IKKUengine/MYiTOPS/teams/Team Malaysia 2019/readme.txt

This is a clone of our folders for mechanical design, software design and organization.
Updated on: 8.5.19
