IKKUengine/MYiTOPS/teams/Team Malaysia 2019/Proposal/MindMap.pptx

from Car (CAN)

external

Dyno

Motor Control

Actuator

Speed

position sensor

Stepper

Sensor

failsafe

mech. failsafe

Remote Actuator

Labview

Software

Controller

Speed Controller PID (limits!)

Remote Controle

Raspberry Pie

phone

computer
