IKKUengine/MYiTOPS/teams/Team Malaysia 2019/Software/GUI.docx

send:

speed

- +/- arrow
- create profile with datapoints and time
- load .csv file

(angle of throttle)

emergency button

recieve:

current speed of car

throttle position from pid controller loop
