IKKUengine/MYiTOPS/teams/Team Malaysia 2019/Presentations/Sternfeuerung 1_0_Skype Meeting.pptx

## Sternfeuerung 1.0

## How does it work? Part 1

#include: Tkinter

→ for graphic user interface (gui)

#include: PyLSL

→ Lab streaming layer
- transfer data in a LAN
- Fastest possible latency

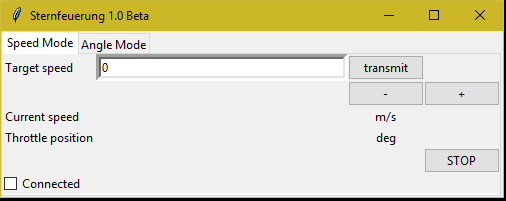
[picture p16: figure]
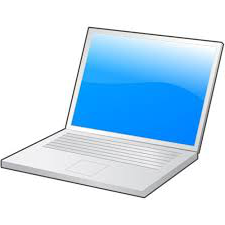
[picture p17: figure]
Bildergebnis fÃ¼r laptop zeichnung

User data

## How does it work? Part 2

Hamachi Server simulates a local area network (LAN)

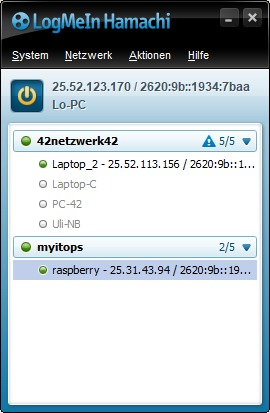
[picture p18: figure]
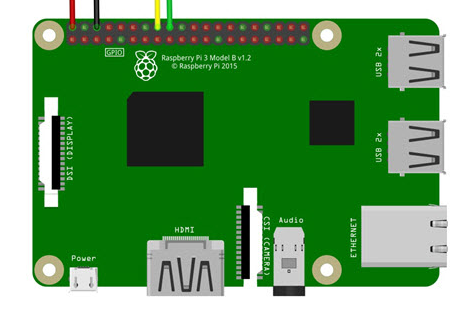
[picture p19: figure]
Bildergebnis fÃ¼r microcontroller raspberry schema

## How does it work? Part 3

#include: PiGPIO

→ Stable servo motor signal
→ CPU load independent

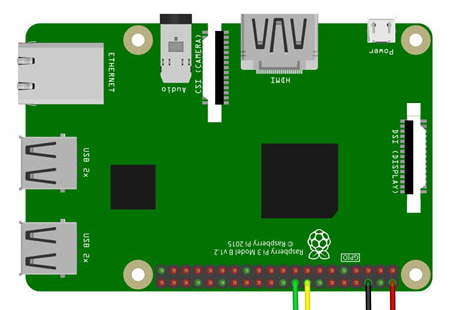
[picture p20: figure]
Bildergebnis fÃ¼r microcontroller raspberry schema

Actual Vehicle Speed

Actuator

## How does it work? Part 4

Actual Vehicle Speed

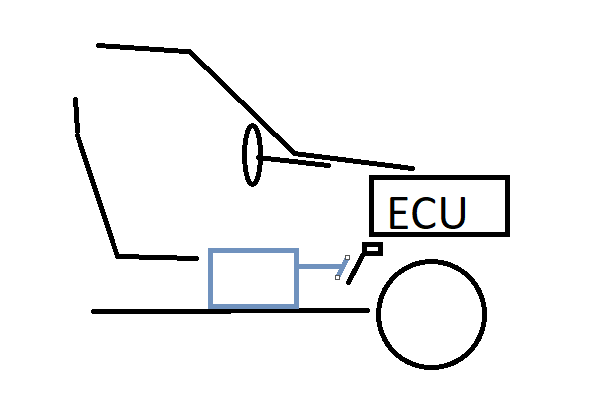
[picture p21: figure]

Throttle position

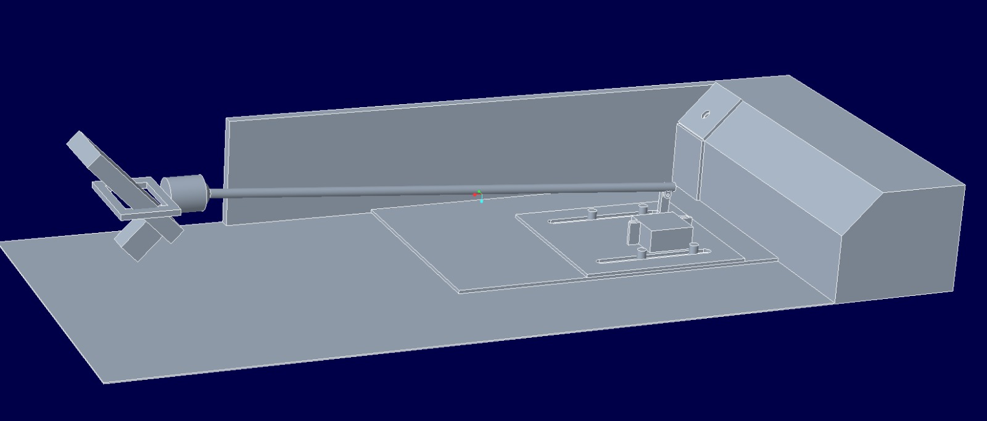
[picture p22: figure]

Actuator

## Slide 6

## How does it work? All in one

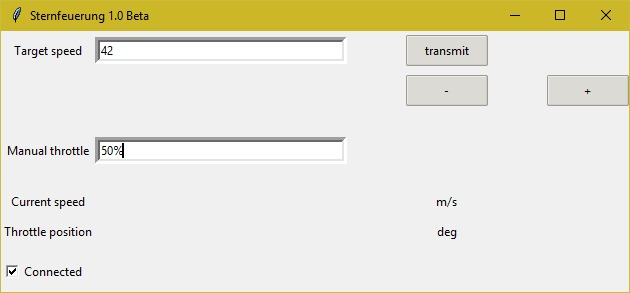
[picture p23: figure]

User data
