IKKUengine/MYiTOPS/teams/Team Malaysia 2019/Proposal/Actuator comparison.xlsx

article | Servo Motor | Linear Actuator
picture
Link | https://shopee.com.my/JX-CLS6336HV-Digital-Metal-Gear-Coreless-Motor-Servo-35.6kg-Torque-Aluminum-fyfb-i.111564047.1921093403 | https://www.lazada.com.my/products/12v-200n-100150200300mm-linear-actuator-motor-stroke-electric-door-opener-i441685108-s652625813.html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
easy assembly | easy attach of a lever servo motor is constantly poweering to hold the torque | direct mounting to throttle need of a displacement measurement
price | RM120.05 | RM103.23
displacement /angle per time | 545°/s | 30mm/s
force/torque | 35,6kNm | 200N
controle | Controllable angle range from 0 to 180 degrees given by a PWM signal | 0V to 12V to drive forward 0V to -12V to drive reverse no feedback about position
