IKKUengine/MYiTOPS/teams/Team Malaysia 2019/Proposal/team organization.docx

Project Manager
(Uli )
Mechanical Engineer
(Azril)
Software Engineer
(Lorenz)
Software Engineer
(Syakir)
Electrical Engineer
(Nurain)
Electrical Engineer
(Jakob)

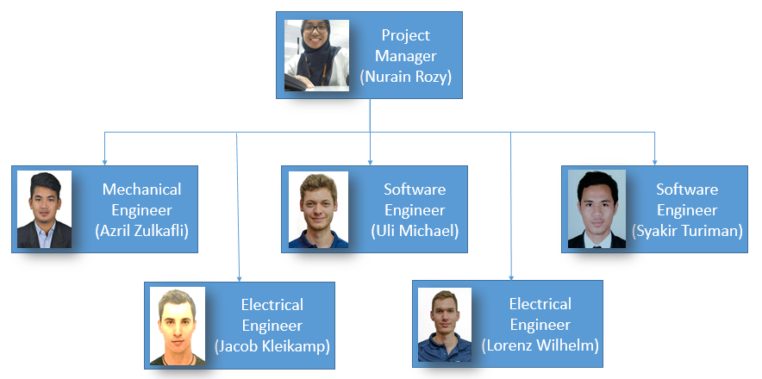
[picture p45: figure]
