IKKUengine/MYiTOPS/teams/Team Malaysia 2019/Proposal/team organization.pptx

Project Manager
(Nurain Rozy)

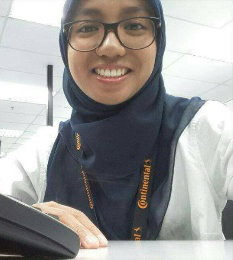
[picture p46: figure]

Mechanical
Engineer
(Azril Zulkafli)

Software Engineer
(Uli Michael)

Software Engineer
(Syakir Turiman)

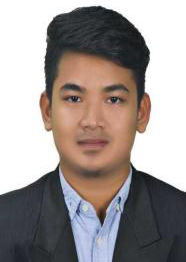
[picture p47: figure]
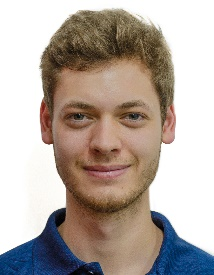
[picture p48: figure]
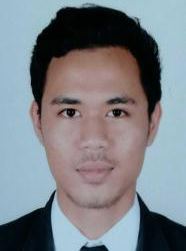
[picture p49: figure]

Electrical Engineer
(Jacob Kleikamp)

Electrical Engineer
(Lorenz Wilhelm)

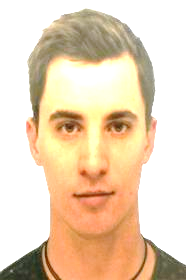
[picture p50: figure]
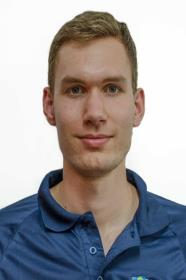
[picture p51: figure]
