IKKUengine/MYiTOPS/procurement workshop/2020/Rechnung_Masken.pdf

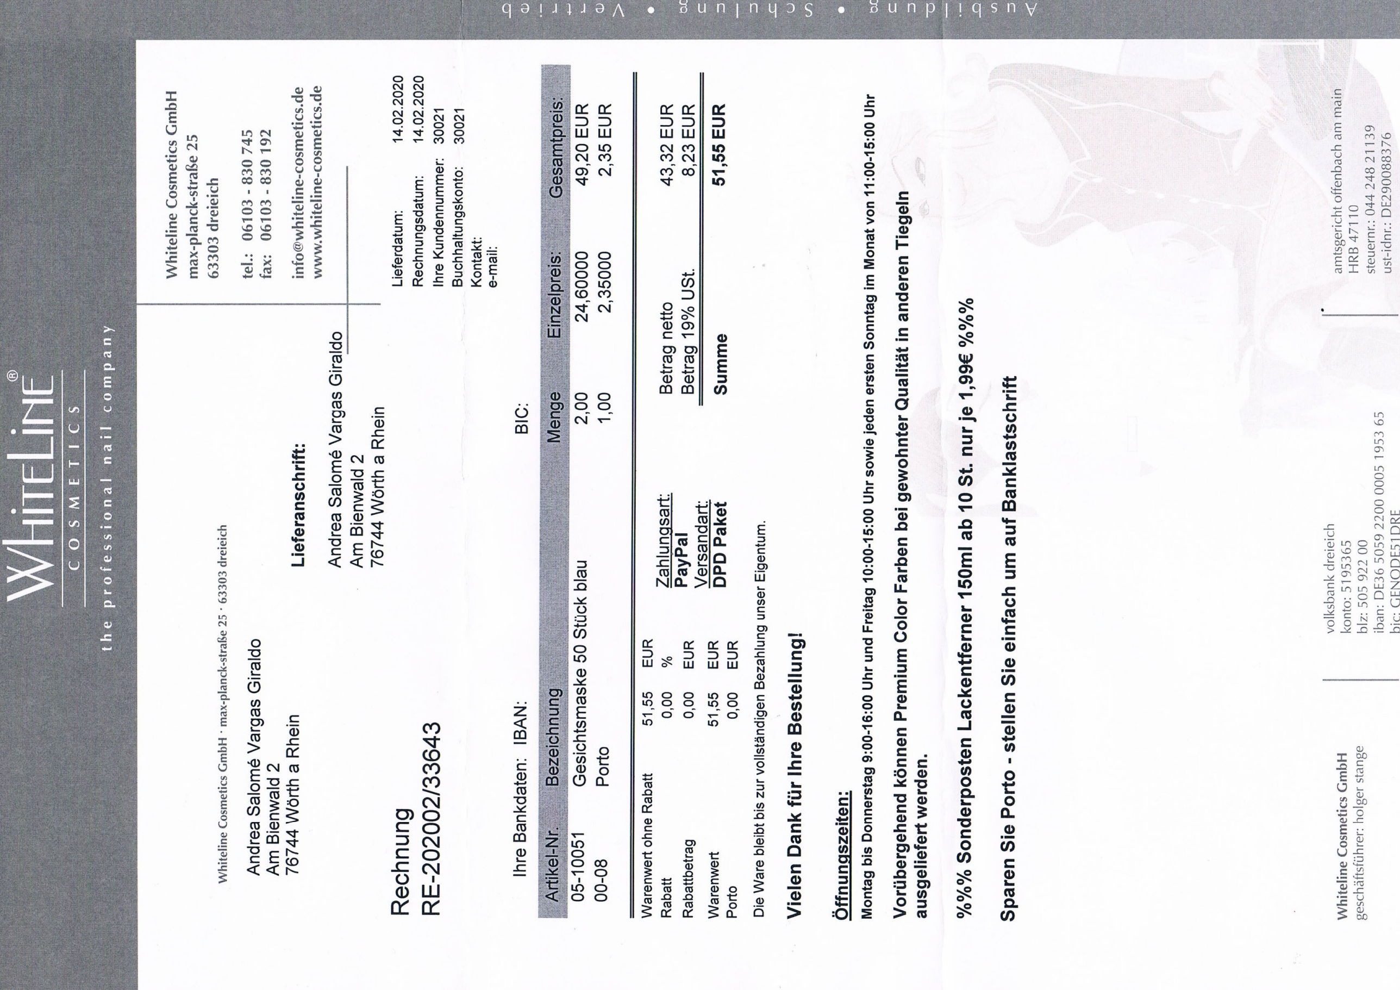
[picture p52: page 1]
