IKKUengine/MYiTOPS/teams/Team Malaysia 2019/Software/pingtest_from_germany.png

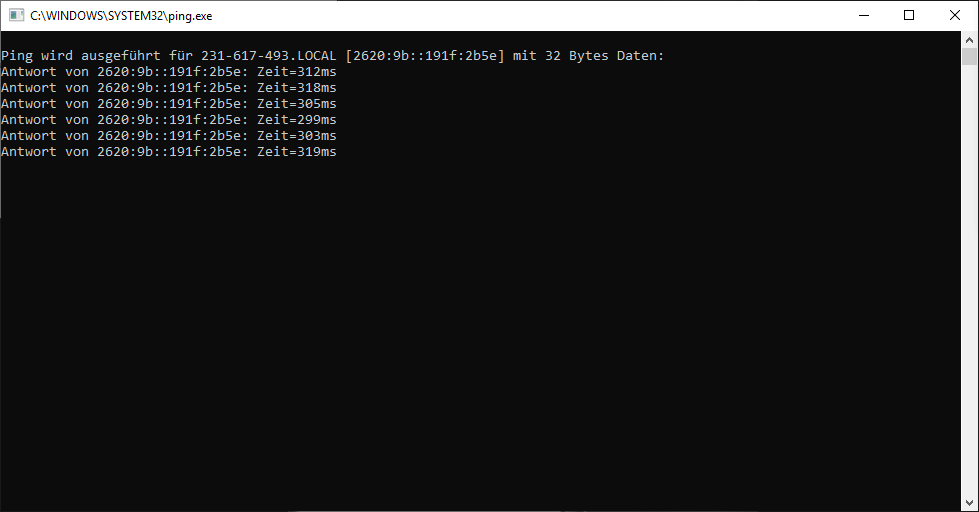
teams/Team Malaysia 2019/Software/pingtest_from_germany.png
