IKKUengine/MYiTOPS/teams/Team Malaysia 2020/Chainsaw/Order List_MYiTOPS V2.xlsx

No | Team | Komponente | Abmessungen (HxBxT) | Hersteller | Stückzahl | Kaufteil [ja/nein] | Shop | Bestellnummer | Kosten (netto)/ Stk | Kosten gesamt (netto) | Kosten gesamt (brutto) | Bemerkung | Link
1 | Group 1 | Battery Management System | Chip | CN | 1 | ja | Banggod.com |  | 2.00 € | 2.00 € | 2.00 € | Bestellt von Johannes K | https://de.banggood.com/3_7V7_4V-11_1V14_8V-Li-po-Battery-Indicator-Display-Board-Power-Storage-Monitor-p-1096280.html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
2 | Group 2 | Step-Down Spannungsregler LM 2596 | Chip | Geekcreit | 1 | ja | Banggod.com |  | 3.24 € | 3.24 € | 5.00 € | Bestellt von Johannes K | https://www.banggood.com/de/LM2596-DC-DC-Voltage-Regulator-Adjustable-Step-Down-Power-Supply-Module-With-Display-p-1005123.html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
3 | Group 2 | Kabelverschraubungen | - | Wiska | 10 | ja | Conrad.de |  | 0.47 € | 5 € | 5.00 € |  | https://www.conrad.de/de/p/kabelverschraubung-verschraubbar-mit-gegenmutter-pg9-pg9-polyamid-grau-1-1521119.html
4 | Group 2 | Zylinderschrauben 20 mm | M3 | Toolcraft | 2 | ja | Conrad.de |  | 2.49 € | 5 € | 5.00 € |  | https://www.conrad.de/de/p/toolcraft-830289-zylinderschrauben-m3-20-mm-innensechskant-din-912-kunststoff-polyamid-10-830289.html
5 | Group 2 | Nutensteine für 10 mm Nuten | M8 | Stritzelsberger | 2 | ja | Vakuumtisch.de |  | 14.99 € | 30 € | 30 € |  | https://www.vakuumtisch.de/Gussaluminium-T-Nutensteine-mit-M8-Gewinde-fuer-10mm-Nuten-10er-Pack
6 | Group 2 | Rundstecker | 3-Polig | TRUcomponents | 3 | ja | Conrad.de |  | 8.57 € | 25.71 € | 30.00 € |  | https://www.conrad.de/de/p/tru-components-1572445-rundstecker-konfektioniert-stecker-gerade-buchse-gerade-gesamtpolzahl-3-1-1572445.html
7 | Group 3 | Step-Down Spannungsregler LM 317 | Chip | QITA | 1 | ja | Conrad.de |  | 4.42 € | 5.00 € | 5.00 € |  | https://www.conrad.de/de/p/lm317-dc-dc-einstellbarer-step-down-spannungsregler-adjustable-konverter-802244045.html
8 | Group 3 | GPRS GSM Breakout-Modul | Chip | ARCELI | 1 | ja | Amazon.de |  | 7.99 € | 8.00 € | 8.00 € | Bestellt von Johannes K | https://www.amazon.de/ARCELI-Kleinster-Breakout-Modul-Quad-Band-SIM-Kartensteckplatz/dp/B07RHLP45T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
9 | Group 2 | Sechskantmuttern M3 | M3 | Toolcraft | 2 | ja | Conrad.de |  | 1.49 € | 2.98 € | 3.00 € |  | https://www.conrad.de/de/p/toolcraft-815969-sechskantmuttern-m3-kunststoff-10-815969.html
 |  |  |  |  |  |  |  |  |  | Gesamt | 93.00 €
