IKKUengine/MYiTOPS/teams/Team Malaysia 2019/Proposal/selection of criteria.xlsx

Sheet: Ranking
actuator to push the trottle | easy assembly | price | displacement/angle per time | force/torque | control | number of + signs | weighting
 |  |  |  |  |  | "+" | gK
easy assembly |  | + | - | - | - | 1 | 0.12
price | - |  | - | - | - | 0 | 0.00
displacement/angle per time | + | + |  | o | - | 2 | 0.25
force/torque | + | + | o |  | o | 2 | 0.25
control | + | + | + | o |  | 3 | 0.38
 |  |  |  |  |  | 8 | 1.00

Sheet: Hintergrundverknüpfungen
Quelle dropdown Ranking | +
 | -
 | o
 | ?
