IKKUengine/MYiTOPS/teams/Team Malaysia 2019/Actuator mechanical design/updated actuator.STEP

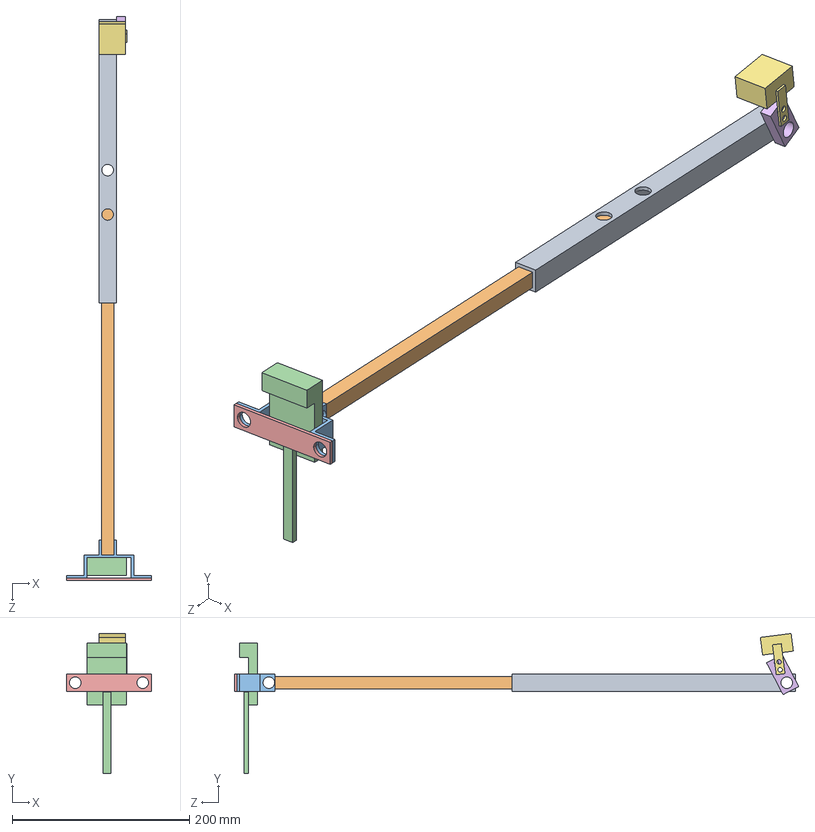
[picture p58: CAD file, 2020-02-21]
teams/Team Malaysia 2019/Actuator mechanical design/updated actuator.STEP
96.0 x 157.8 x 636.3 mm
