IKKUengine/MYiTOPS/teams/Team Malaysia 2019/Actuator mechanical design/actuator.edited.STEP

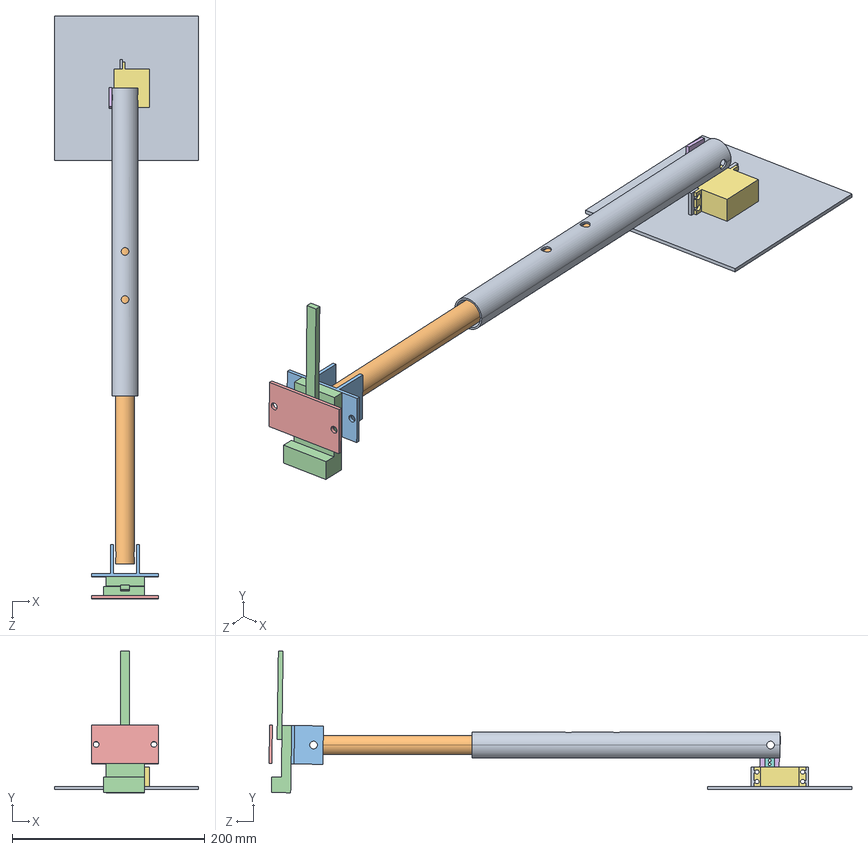
[picture p59: CAD file, 2020-02-21]
teams/Team Malaysia 2019/Actuator mechanical design/actuator.edited.STEP
150.0 x 147.1 x 605.7 mm
Big rod
Small rod
Pedal clamp
Gas pedal
Rear clamp
Lever
servo_rotational
servo arm
