IKKUengine/MYiTOPS/teams/Team Malaysia 2019/Actuator mechanical design/drawing actuator.STEP

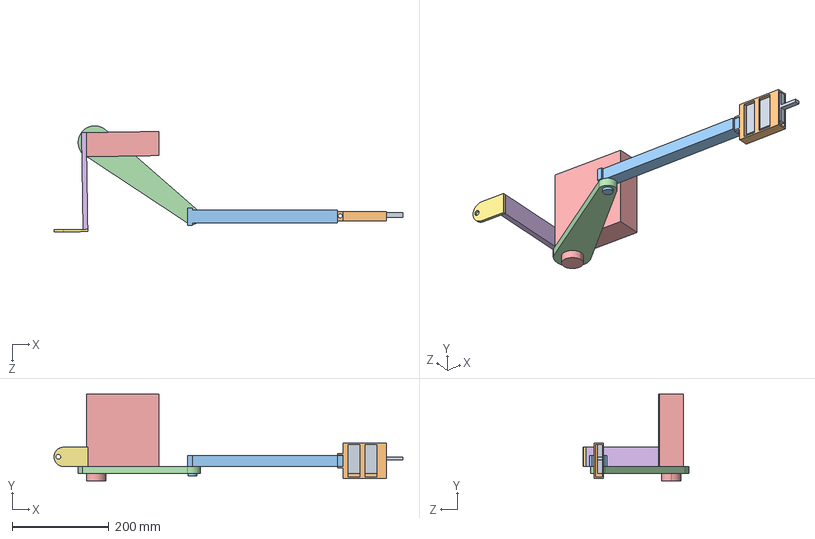
[picture p60: CAD file, 2020-02-21]
teams/Team Malaysia 2019/Actuator mechanical design/drawing actuator.STEP
722.3 x 180.0 x 220.1 mm
