IKKUengine/MYiTOPS/teams/Team Malaysia 2019/Actuator mechanical design/servo_rotational.stp

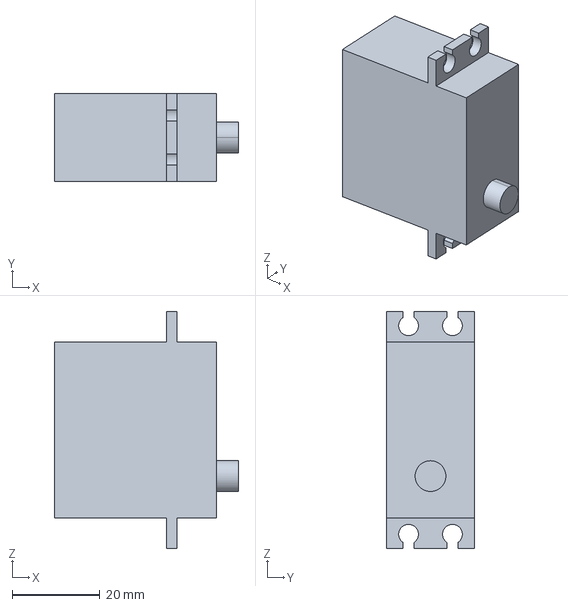
[picture p61: CAD file, 2020-02-21]
teams/Team Malaysia 2019/Actuator mechanical design/servo_rotational.stp
42.0 x 20.0 x 54.0 mm
