IKKUengine/MYiTOPS/teams/Team Malaysia 2019/Actuator mechanical design/M8_Metric_Nut.stp

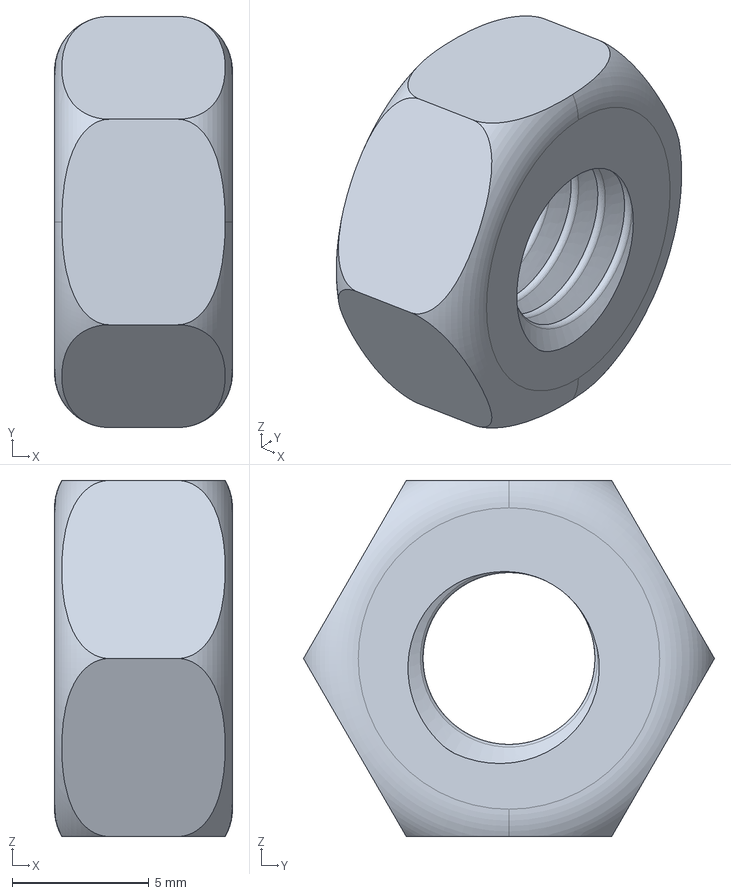
[picture p62: CAD file, 2020-02-21]
teams/Team Malaysia 2019/Actuator mechanical design/M8_Metric_Nut.stp
6.50 x 15.0 x 13.0 mm
