IKKUengine/MYiTOPS/(list of files, cad)

Other CAD files:
teams/Team Malaysia 2019/Actuator mechanical design/actuator 3d view.SLDDRW
teams/Team Malaysia 2019/Actuator mechanical design/drawing actuator.SLDASM
