IKKUengine/MYiTOPS/teams/Team Malaysia 2019/Proposal/Scematic of setup.pptx

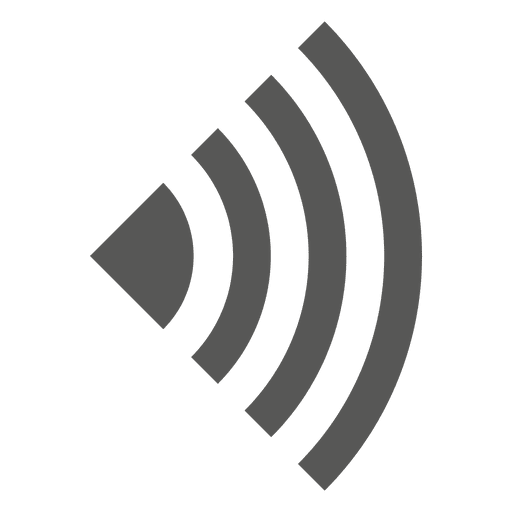
[picture p63: figure]
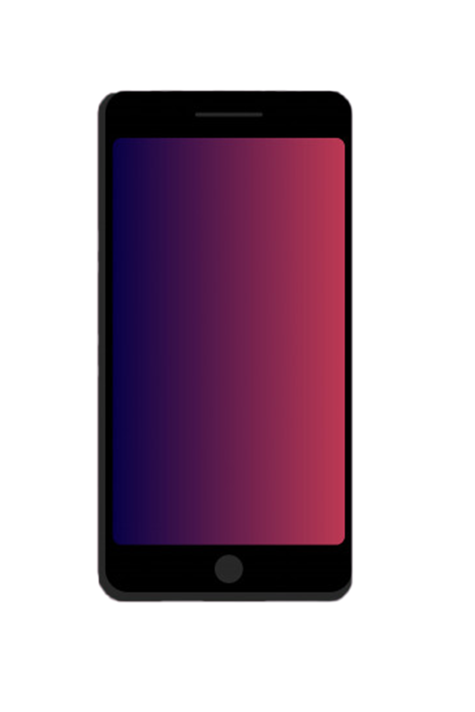
[picture p64: figure]

Controller

Speed

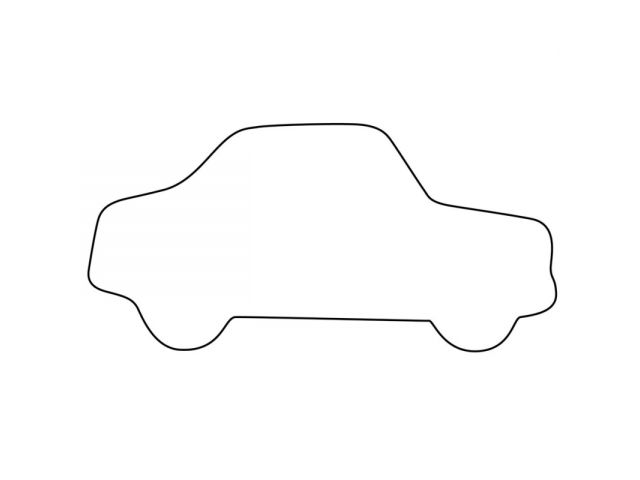
[picture p65: figure]
Ein Bild, das drinnen, Objekt, Himmel enthält. Mit hoher Zuverlässigkeit generierte Beschreibung

Sensor

Speed

Voltage

Position

Actuator

Throttle
