IKKUengine/MYiTOPS/breadboard_RPI_MYiTOPS.pdf

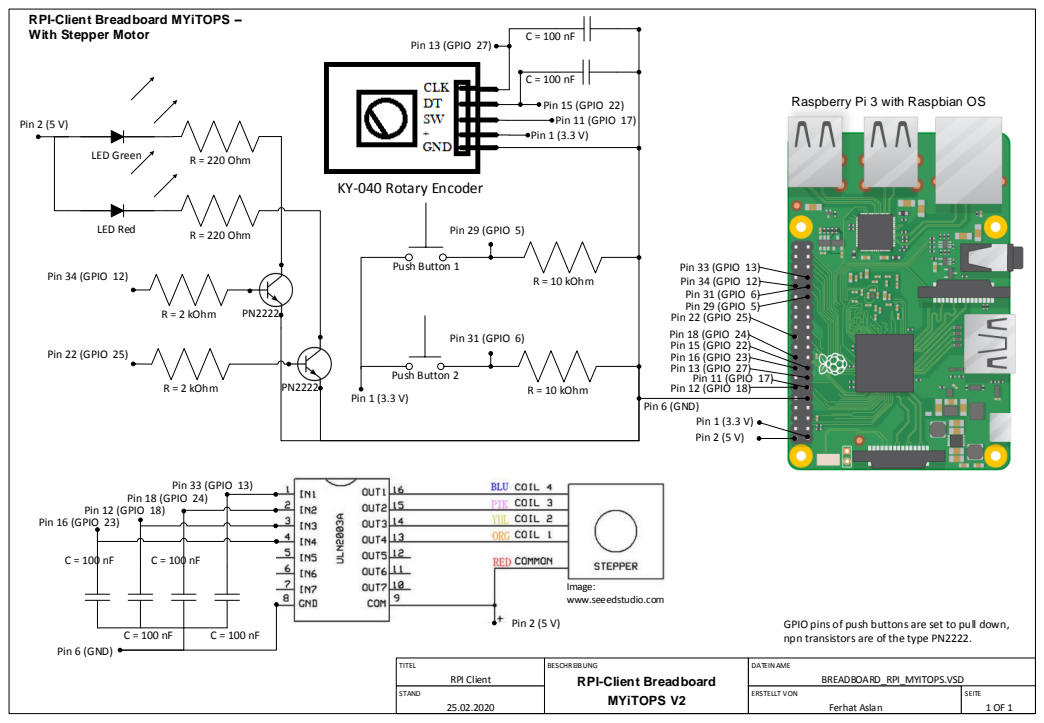
[picture p67: page 1]
ERSTELLT VON; Ferhat Aslan; DATEINAME; BREADBOARD_RPI_MYITOPS.VSD; SEITE; STAND; TITEL; RPI Client; LED Green; R = 220 Ohm; LED Red; Push Button 2; Push Button 1; R = 10 kOhm; Pin 6 (GND); Pin 2 (5 V); Pin 15 (GPIO 22); Pin 1 (3.3 V); Pin 11 (GPIO 17); Pin 13 (GPIO 27); Pin 34 (GPIO 12); Pin 22 (GPIO 25); Pin 29 (GPIO 5); Pin 31 (GPIO 6); Pin 12 (GPIO 18); Pin 16 (GPIO 23); Pin 18 (GPIO 24); Pin 33 (GPIO 13); R = 2 kOhm; Pin 33 (GPIO 13) Pin 18 (GPIO 24) Pin 12 (GPIO 18) Pin 16 (GPIO 23)

RPI-Client Breadboard MYiTOPS –
With Stepper Motor

Raspberry Pi 3 with Raspbian OS

KY-040 Rotary Encoder

Image:
www.seeedstudio.com

GPIO pins of push buttons are set to pull down,
npn transistors are of the type PN2222.

BESCHREIBUNG
RPI-Client Breadboard
MYiTOPS V2
