IKKUengine/MYiTOPS/teams/Team Malaysia 2019/Actuator mechanical design/drawings/bigtube.pdf

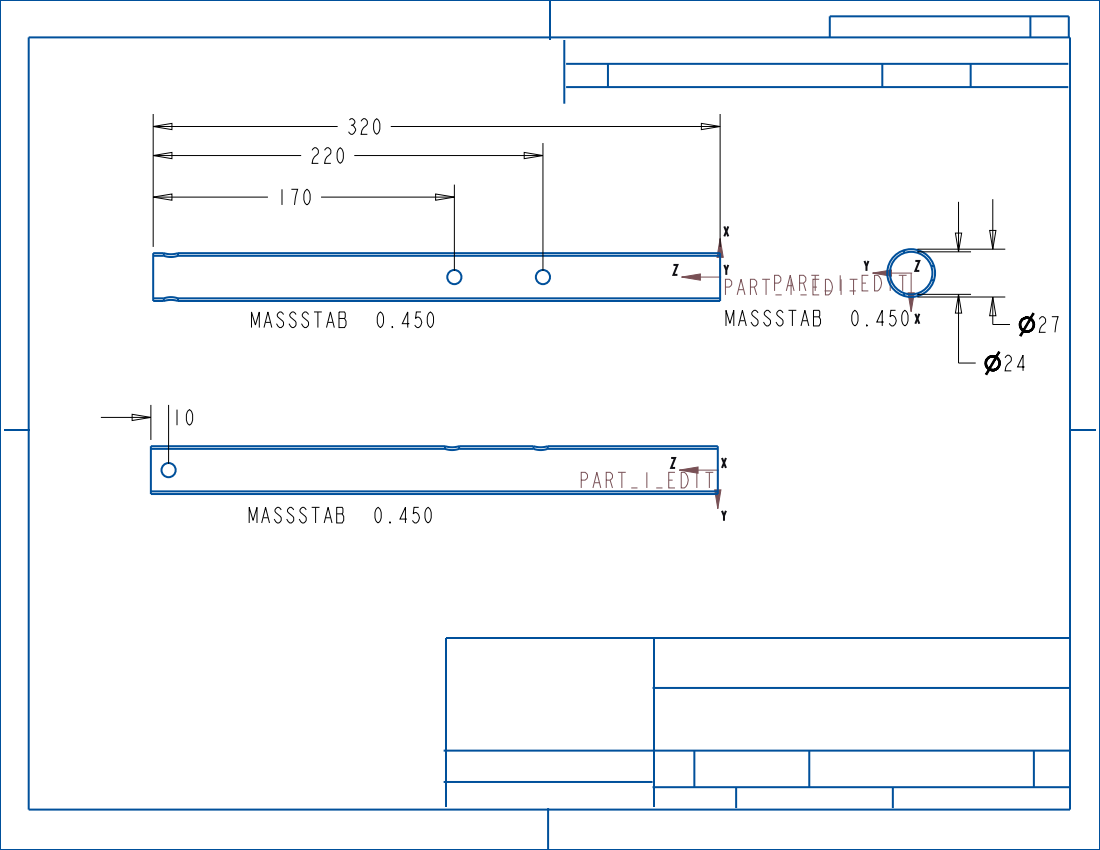
[picture p68: page 1]
PART_1_EDIT; Z PART_1_EDIT; MASSSTAB 0.450
