IKKUengine/MYiTOPS/teams/Team Malaysia 2019/Actuator mechanical design/drawings/clamp_back.pdf

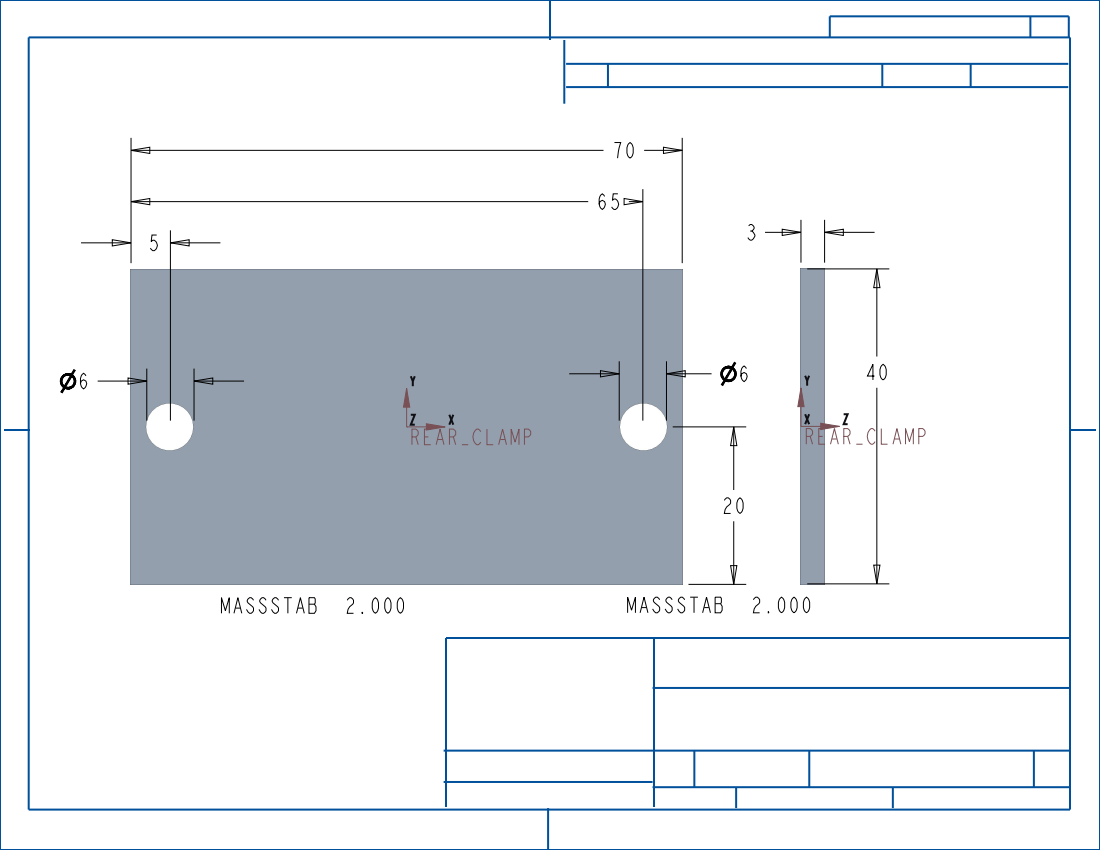
[picture p69: page 1]
Z REAR_CLAMP; MASSSTAB 2.000
