IKKUengine/MYiTOPS/teams/Team Malaysia 2019/Actuator mechanical design/drawings/lever.pdf

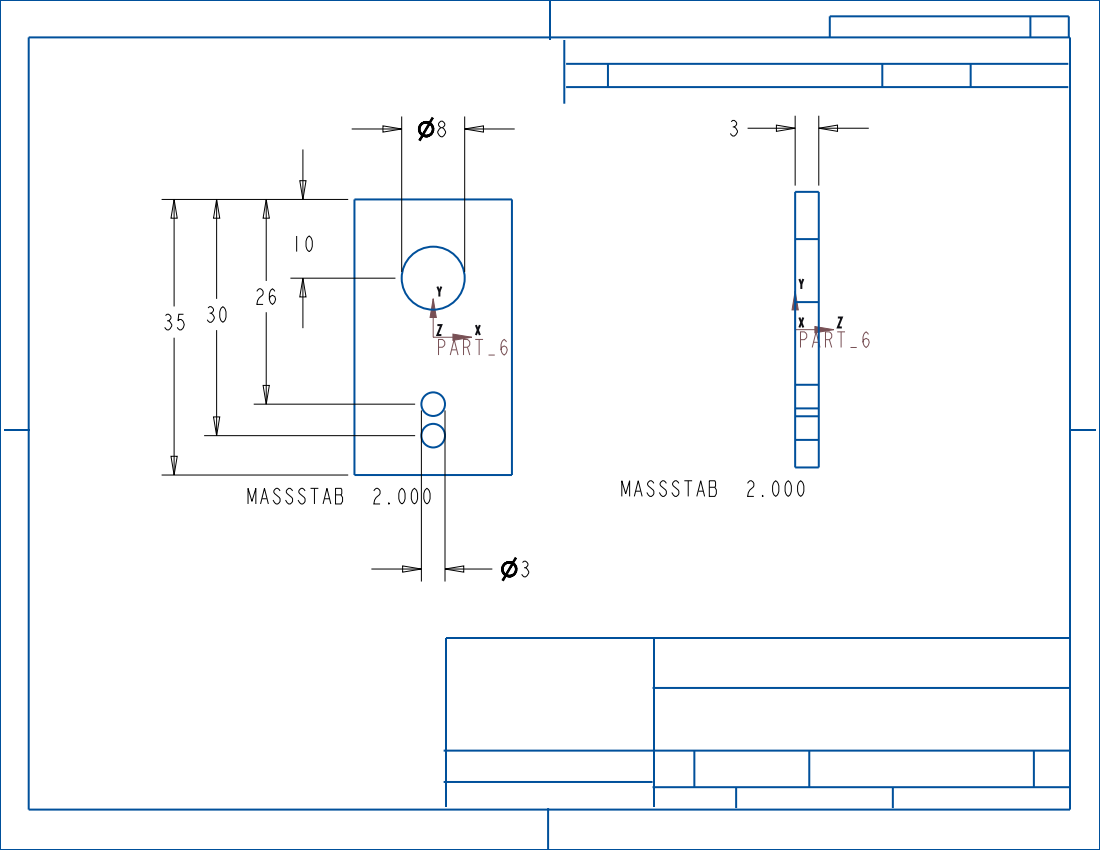
[picture p70: page 1]
Z PART_6; MASSSTAB 2.000
