IKKUengine/MYiTOPS/teams/Team Malaysia 2019/Actuator mechanical design/drawings/pedal_clamp.pdf

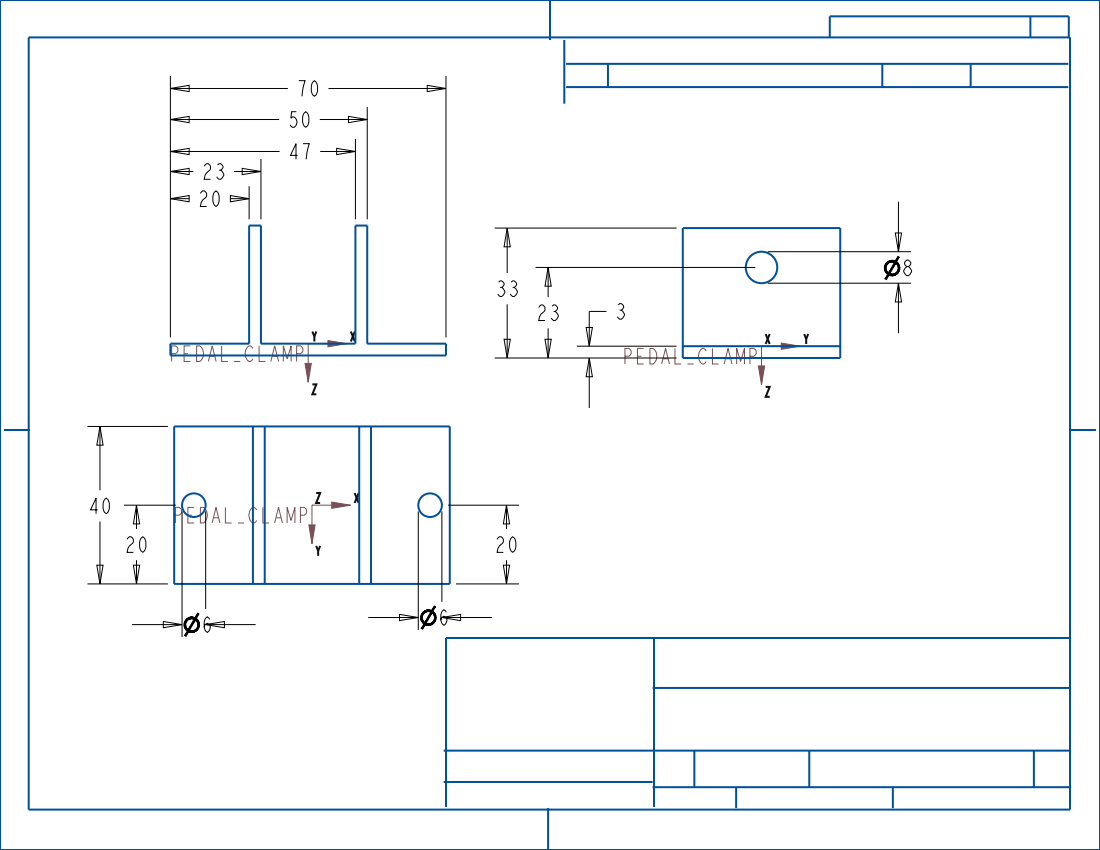
[picture p71: page 1]
PEDAL_CLAMP
