IKKUengine/MYiTOPS/teams/Team Malaysia 2019/Actuator mechanical design/drawings/thintube.pdf

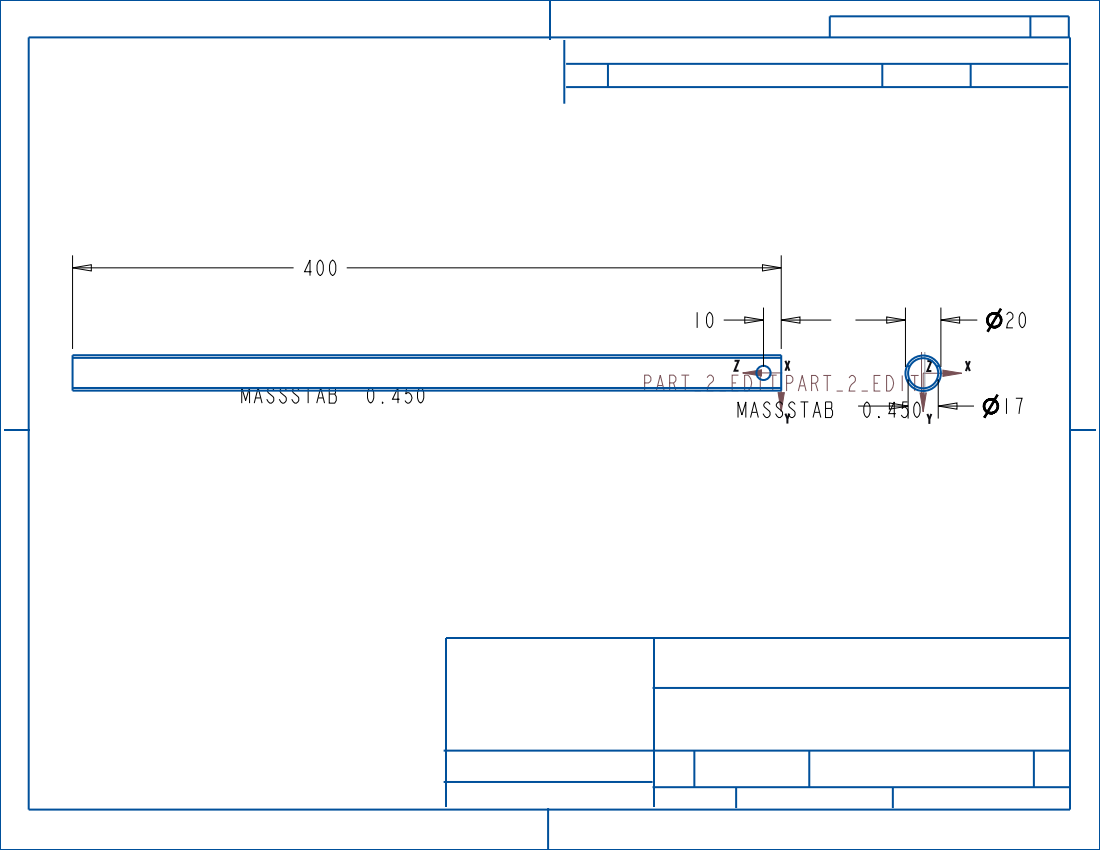
[picture p72: page 1]
PART_2_EDIT; Z PART_2_EDIT; MASSSTAB 0.450; 17 MASSSTAB 0.450
