IKKUengine/MYiTOPS/(commit log)

2020-02-21 fix: new folder order
    [Actuator comparison.xlsx, M8_Metric_Nut.stp, actuator 3d view.SLDDRW, actuator.edited.STEP, drawing actuator.SLDASM, drawing actuator.STEP, selection of criteria.xlsx, servo_rotational.stp]
2020-02-25 feat: test_stepper2.py working stepper code
2020-02-26 fix: add condersor for the driver siganls
2020-02-26 bug:working modified controlling for the new syste
    [RPIClient_DemoBoard.py]
2020-02-28 fix: change names and start value of stepper steps
2020-11-03 feat: update with the chainsaw project documents 2020
    [Order List_MYiTOPS V2.xlsx]
